uidbej/Balancar/Docs/Images/PID原理图.PNG

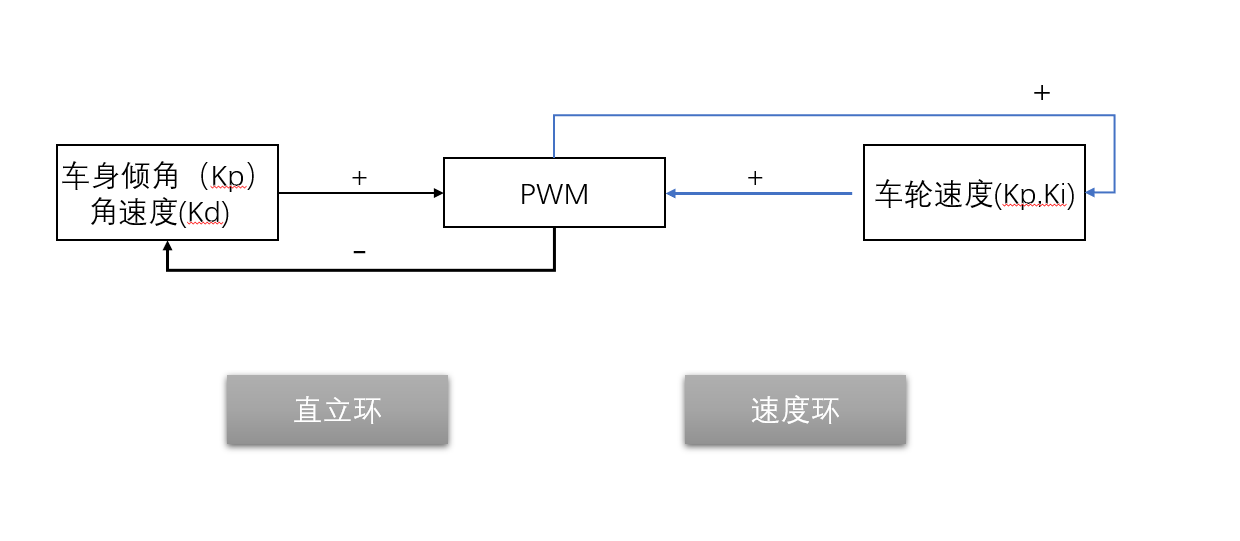
Docs/Images/PID原理图.PNG
